TheSkorm/IC-9350/dwg/706mk2-basic.pdf

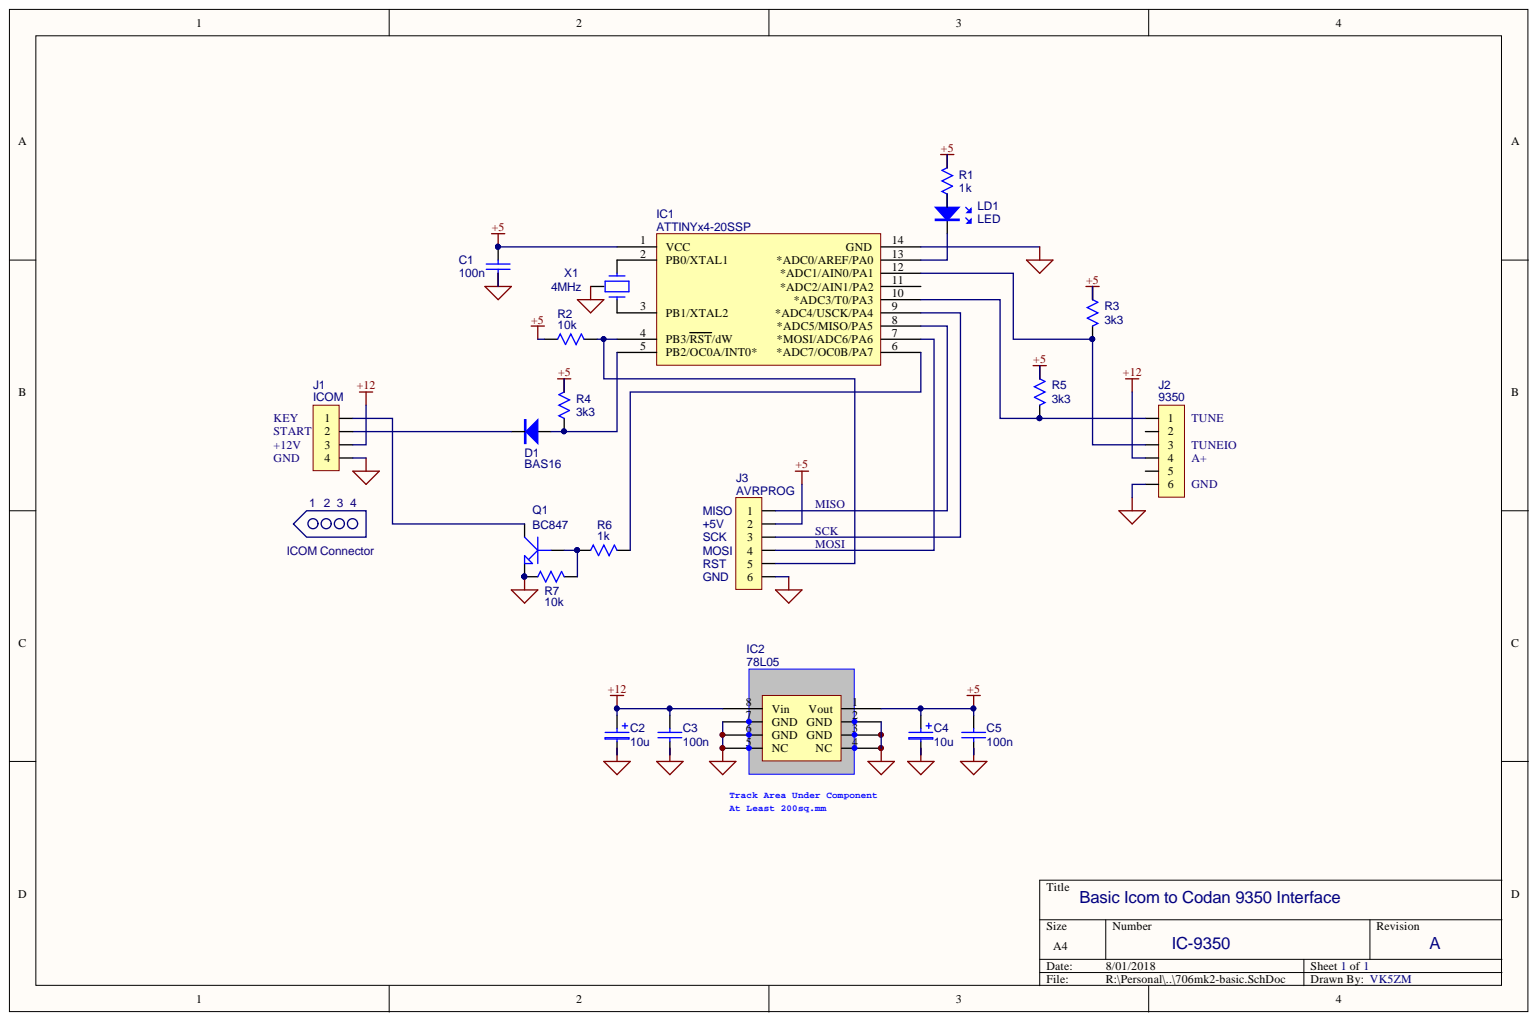
[picture p3: page 1]

Track Area Under Component
At Least 200sq.mm

Title
Basic Icom to Codan 9350 Interface
