TheSkorm/IC-9350/Icom9350/Icom9350.ino

/*
    Icom IC-7000/706 to Codan 9350 Adaptor Software
    Copyright (C) 2015-2016 Mark Jessop <vk5qi@rfhead.net>
	Changelog:
      - v1.0.1: Fix the delays to work with a 8MHz crystal. Should also now work with
                any clock speed Arduino's delay functions support.
	  - v1.0.2: Changed to 4MHz Crystal.  Updated build information.  Removed scan_mode
				functions since this is not compatible with Icom interface, tidied up loop()
				function names slightly.
    - v1.0.3: Change to using an Arduino Nano

  Interface PCB through to 9350 Pin Connections:
  
    - NGTs and Envoys use the 6-way 'microphone' connector.
    - Older codan rigs (9323, 8528) use a DB15 connector.
    - The 9350 itself uses MIL-Spec Amphenol connector
    
    Function        9350 Pin        6-way Pin       DB15 Pin        Interface PCB Pin
    ---------------------------------------------------------------------------------
    +12V            A (Red)         4               12+13           4
    Earth           B (Black)       6               14+15           6
    Tune            C (Blue)        1               4               1
    Scan            D (Green)       2               5               2
    Tune Status     E (Yellow)      3               11              3
    Not Connected   F
    The MIT License (MIT)
    Permission is hereby granted, free of charge, to any person obtaining a copy
    of this software and associated documentation files (the "Software"), to deal
    in the Software without restriction, including without limitation the rights
    to use, copy, modify, merge, publish, distribute, sublicense, and/or sell
    copies of the Software, and to permit persons to whom the Software is
    furnished to do so, subject to the following conditions:
    The above copyright notice and this permission notice shall be included in all
    copies or substantial portions of the Software.
    THE SOFTWARE IS PROVIDED "AS IS", WITHOUT WARRANTY OF ANY KIND, EXPRESS OR
    IMPLIED, INCLUDING BUT NOT LIMITED TO THE WARRANTIES OF MERCHANTABILITY,
    FITNESS FOR A PARTICULAR PURPOSE AND NONINFRINGEMENT. IN NO EVENT SHALL THE
    AUTHORS OR COPYRIGHT HOLDERS BE LIABLE FOR ANY CLAIM, DAMAGES OR OTHER
    LIABILITY, WHETHER IN AN ACTION OF CONTRACT, TORT OR OTHERWISE, ARISING FROM,
    OUT OF OR IN CONNECTION WITH THE SOFTWARE OR THE USE OR OTHER DEALINGS IN THE
    SOFTWARE.
*/

// Pin definitions for VK5ZM designed ATTiny44A interface PCB R0V3.

#define ICOM_START    6
                        
#define ICOM_KEY      3 

#define CODAN_TUNE    A3
#define CODAN_TUNEIO  A5

#define LED           LED_BUILTIN

void setup()
{
  // Setup output pins.
  pinMode(LED, OUTPUT);
  digitalWrite(LED, HIGH);
  pinMode(ICOM_KEY, OUTPUT);
  digitalWrite(ICOM_KEY, LOW);

  // Setup Input Pins
  pinMode(ICOM_START, INPUT);
  pinMode(CODAN_TUNEIO, INPUT);
  pinMode(CODAN_TUNE, INPUT);
}

void loop()
{
  //Wait until ICOM_START is pulled low
  while (digitalRead(ICOM_START)) {}

  //Delay for 200ms. This allows us to check if the Icom radio has requested a tune, or a tuner reset
  delay(200);

  // Check state of ICOM_START line
  if (digitalRead(ICOM_START))
  {
    //was high so had to be a tune reset command
    tune_reset();
  }
  else
  {
    //still low was a tune request
    tune_start();
  }

  //Delay for a short time, so we don't re-tune accidentally
  delay(400);   //400ms
}

void tune_reset()
{
  /* There is nothing to reset on the 9350, so do nothing in this function for the time being */
}

void tune_start()
{
  // Turn on Indicator LED.
  digitalWrite(LED, LOW);

  // Assert ICOM_KEY line, indicating to the Icom we are in tune mode.
  digitalWrite(ICOM_KEY, HIGH);

  // Wait a bit for the Icom to start producing RF.
  delay(350); // Approx 350ms

  // Now we start to talk to the Codan tuner.

  // Assert 9350 tune line low.
  pinMode(CODAN_TUNE, OUTPUT);
  digitalWrite(CODAN_TUNE, LOW);

  // 9350 will now hold this line low until it finishes tuning.
  // Wait a little bit (300ms-ish) before releasing the line
  delay(300);

  // Release the line.
  pinMode(CODAN_TUNE, INPUT);

  delay(30);  // Wait 30ms before trying to read the CODAN_TUNE line.

  // Wait until CODAN_TUNE goes high.
  while (digitalRead(CODAN_TUNE) == 0) {}

  // When line goes high, read CODAN_TUNEIO line immediately.
  // This line indicates if the tune has failed or succeeded
  if (digitalRead(CODAN_TUNEIO))
  {
    tune_pass();
  }
  else
  {
    tune_failed();
  }
}

void tune_failed()
{
  // We can tell the Icom that the tune has failed by releasing ICOM_KEY line for 20ms,
  // holding it low for 200ms, then releasing it again.
  digitalWrite(ICOM_KEY, LOW);
  delay(20); // 20ms
  digitalWrite(ICOM_KEY, HIGH);
  delay(200); // 200ms
  digitalWrite(ICOM_KEY, LOW);
}

void tune_pass()
{
  // Tune OK. Release ICOM Key line.
  digitalWrite(ICOM_KEY, LOW);
  // Turn off LED.
  digitalWrite(LED, HIGH);
}
