TheSkorm/IC-9350/(commit log)

2018-01-08 Updated build information, fixed timing error
    [Icom9350.ino]
2018-01-08 Added schematic
2018-01-08 Fixed changelog which was missing
    [Icom9350.ino]
2019-04-25 Arduino simple build
2019-12-27 Fix typo in setup routine. Add filtering cap
    [Icom9350.ino]
2019-12-27 explain the filtering cap
